unal-edigital2-labs/2020-2-w07_entrega-_final-grupo05/docs/figure/error6.png

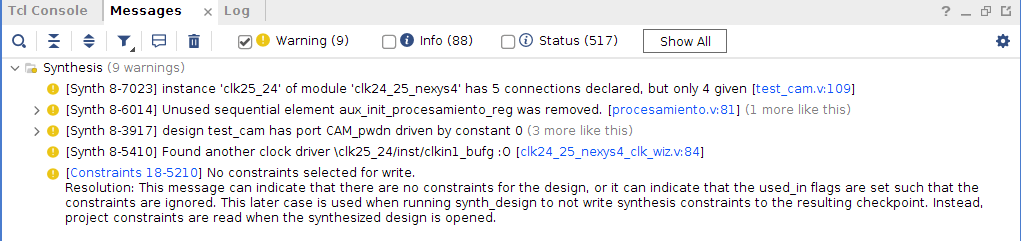
docs/figure/error6.png
