unal-edigital2-labs/2020-2-w07_entrega-_final-grupo05/docs/figure/prueva1ms.png

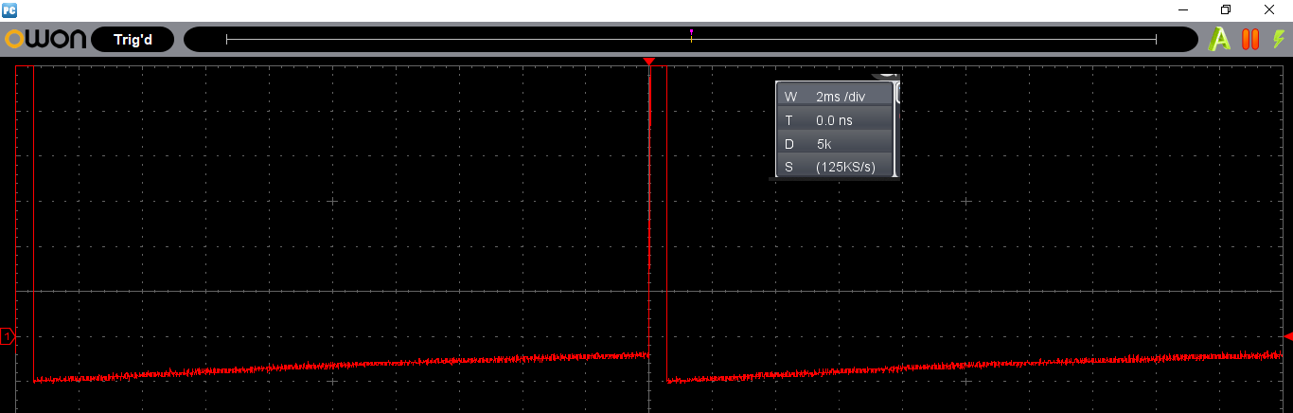
docs/figure/prueva1ms.png
