unal-edigital2-labs/2020-2-w07_entrega-_final-grupo05/docs/figure/pueva15.png

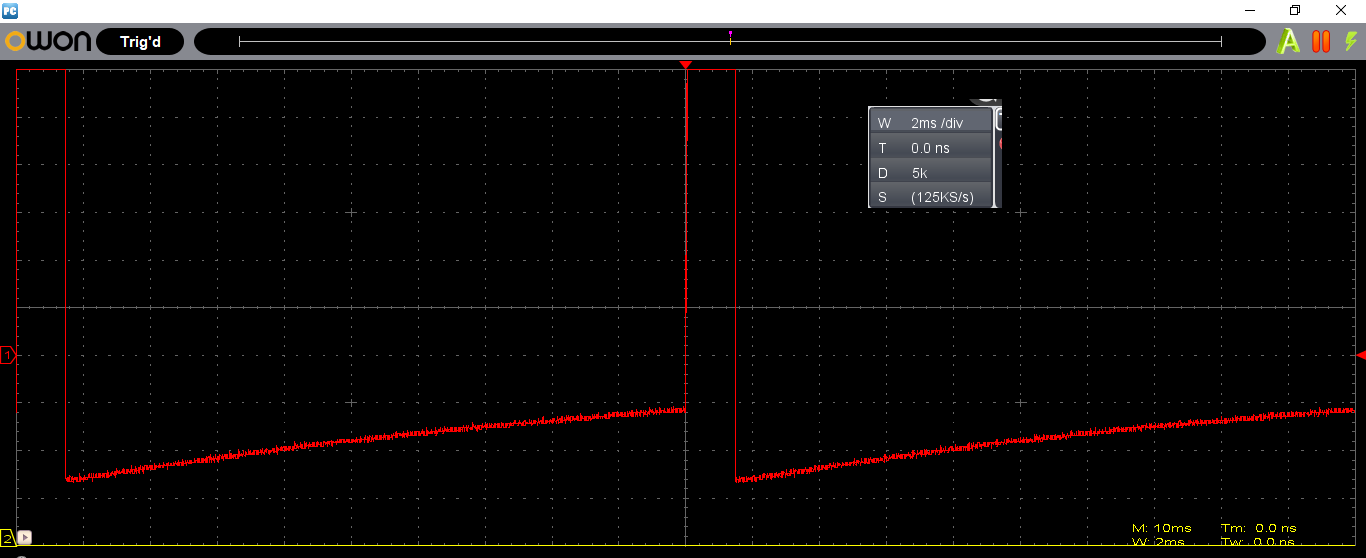
docs/figure/pueva15.png
