unal-edigital2-labs/2020-2-w07_entrega-_final-grupo05/docs/figure/CaputaBuildSoCCPU.jpeg

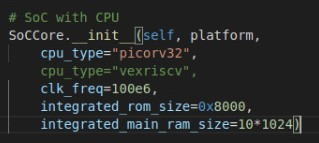
docs/figure/CaputaBuildSoCCPU.jpeg
