unal-edigital2-labs/2020-2-w07_entrega-_final-grupo05/sw/firmware/main.c

#include <stdio.h>
#include <stdlib.h>
#include <string.h>

#include <irq.h>
#include <uart.h>
#include <console.h>
#include <generated/csr.h>

#include "delay.h"
#include "display.h"
#include "camara.h"
#include "radar.h"
#include "motor.h"
#include "infra.h"

static char *readstr(void)
{
	char c[2];
	static char s[64];
	static int ptr = 0;

	if(readchar_nonblock()) {
		c[0] = readchar();
		c[1] = 0;
		switch(c[0]) {
			case 0x7f:
			case 0x08:
				if(ptr > 0) {
					ptr--;
					putsnonl("\x08 \x08");
				}
				break;
			case 0x07:
				break;
			case '\r':
			case '\n':
				s[ptr] = 0x00;
				putsnonl("\n");
				ptr = 0;
				return s;
			default:
				if(ptr >= (sizeof(s) - 1))
					break;
				putsnonl(c);
				s[ptr] = c[0];
				ptr++;
				break;
		}
	}
	return NULL;
}

static char *get_token(char **str)
{
	char *c, *d;

	c = (char *)strchr(*str, ' ');
	if(c == NULL) {
		d = *str;
		*str = *str+strlen(*str);
		return d;
	}
	*c = 0;
	d = *str;
	*str = c+1;
	return d;
}

static void prompt(void)
{
	printf("RUNTIME>");
}

static void help(void)
{
	puts("Available commands:");
	puts("help                            - this command");
	puts("reboot                          - reboot CPU");
	puts("led                             - led test");
	puts("switch                          - switch test");
	puts("display                         - display test");
	puts("rgbled                          - rgb led test");
	puts("vga                             - vga test");
	puts("camara                             - camara test");
	puts("radar                             - radar test"); 
	puts("motor                             - motor test"); 
	puts("infra                            - motor test"); 
}

static void reboot(void)
{
	ctrl_reset_write(1);
}

static void display_test(void)
{
/*	int i;
	signed char defill = 0;	//1->left, -1->right, 0->.
	
	char txtToDisplay[40] = {0, DISPLAY_0, DISPLAY_1,DISPLAY_2,DISPLAY_3,DISPLAY_4,DISPLAY_5,DISPLAY_6,DISPLAY_7,DISPLAY_8,DISPLAY_9,DISPLAY_A,DISPLAY_B,DISPLAY_C,DISPLAY_D,DISPLAY_E,DISPLAY_F,DISPLAY_G,DISPLAY_H,DISPLAY_I,DISPLAY_J,DISPLAY_K,DISPLAY_L,DISPLAY_M,DISPLAY_N,DISPLAY_O,DISPLAY_P,DISPLAY_Q,DISPLAY_R,DISPLAY_S,DISPLAY_T,DISPLAY_U,DISPLAY_V,DISPLAY_W,DISPLAY_X,DISPLAY_Y,DISPLAY_Z,DISPLAY_DP,DISPLAY_TR,DISPLAY_UR};
	
	printf("Test del los display de 7 segmentos... se interrumpe con el botton 1\n");

	while(!(buttons_in_read()&1)) {
		display(txtToDisplay);
		if(buttons_in_read()&(1<<1)) defill = ((defill<=-1) ? -1 : defill-1);
		if(buttons_in_read()&(1<<2)) defill = ((defill>=1) ? 1 : defill+1);
		if (defill > 0) {
			char tmp = txtToDisplay[0];
			for(i=0; i<sizeof(txtToDisplay)/sizeof(txtToDisplay[i]); i++) {
				txtToDisplay[i] = ((i==sizeof(txtToDisplay)/sizeof(txtToDisplay[i])-1) ? tmp : txtToDisplay[i+1]);
			}
		}
		else if(defill < 0) {
			char tmp = txtToDisplay[sizeof(txtToDisplay)/sizeof(txtToDisplay[0])-1];
			for(i=sizeof(txtToDisplay)/sizeof(txtToDisplay[i])-1; i>=0; i--) {
				txtToDisplay[i] = ((i==0) ? tmp : txtToDisplay[i-1]);
			}
		}
		delay_ms(500);
	}
*/
}

static void led_test(void)
{
	unsigned int i;
	printf("Test del los leds... se interrumpe con el botton 1\n");
	while(!(buttons_in_read()&1)) {

	for(i=1; i<65536; i=i*2) {
		leds_out_write(i);
		delay_ms(50);
	}
	for(i=32768;i>1; i=i/2) {
		leds_out_write(i);
		delay_ms(50);
	}
	}
	
}


static void switch_test(void)
{
	unsigned short temp2 =0;
	printf("Test del los interruptores... se interrumpe con el botton 1\n");
	while(!(buttons_in_read()&1)) {
		unsigned short temp = switchs_in_read();
		if (temp2 != temp){
			printf("switch bus : %i\n", temp);
			leds_out_write(temp);
			temp2 = temp;
		}
	}
}
/*
static void rgbled_test(void)
{
	unsigned int T = 128;
	
	ledRGB_1_r_period_write(T);
	ledRGB_1_g_period_write(T);
	ledRGB_1_b_period_write(T);

	ledRGB_1_r_enable_write(1);
	ledRGB_1_g_enable_write(1);
	ledRGB_1_b_enable_write(1);

	
	ledRGB_2_r_period_write(T);
	ledRGB_2_g_period_write(T);
	ledRGB_2_b_period_write(T);
	
	
	ledRGB_2_r_enable_write(1);
	ledRGB_2_g_enable_write(1);
	ledRGB_2_b_enable_write(1);

	for (unsigned int j=0; j<100; j++){
		ledRGB_1_g_width_write(j);
		for (unsigned int i=0; i<100; i++){
			ledRGB_1_r_width_write(100-i);
			ledRGB_1_b_width_write(i);	
			delay_ms(20);
		}	
	}
	


} */


/*
static void vga_test(void)

{
	int x,y;
	
	for(y=0; y<480; y++) {
		for(x=0; x<640; x++) {
			vga_cntrl_mem_we_write(0);
			vga_cntrl_mem_adr_write(y*640+x);
			if(x<640/3)	
				vga_cntrl_mem_data_w_write(((int)(x/10)%2^(int)(y/10)%2)*15);
			else if(x<2*640/3) 
				vga_cntrl_mem_data_w_write((((int)(x/10)%2^(int)(y/10)%2)*15)<<4);
			else 
				vga_cntrl_mem_data_w_write((((int)(x/10)%2^(int)(y/10)%2)*15)<<8);
			vga_cntrl_mem_we_write(1);
		}
	}
	
}
*/
static void camara_test(void)
{
	unsigned short figura=0;
	unsigned short color=0;
	unsigned short done=0;	
	
		
	printf("Hola mundo");
		
	while(!(buttons_in_read()&1)) {

        camara_cntrl_init_procesamiento_write(1);
        delay_ms(2);
        camara_cntrl_init_procesamiento_write(0);
		delay_ms(2);

		done=camara_cntrl_done_read();
		figura=camara_cntrl_figure_read();
		color=camara_cntrl_color_read();
		
		
		
		printf("Done : %i\n", done); 

		if(figura==1) 
			printf("Triangulo\n");
		else if(figura==2) 
			printf("Circulo\n");
		else if(figura==3) 
			printf("Cuadrado\n");
		else if(figura==0) 
			printf("Figura no definida\n");

		if(color==1) 
			printf("Rojo\n");
		else if(color==2) 
			printf("Verde\n");
		else if(color==3) 
			printf("Azul\n");
		else if(color==0) 
			printf("Color no definido\n");
			
		delay_ms(500);
	} 
}

static void radar_test(void)
{
		
	printf("Hola mundo");
		
	while(!(buttons_in_read()&1)) {

    radar_cntrl_boton_cambiar_grados_write(1);
	delay_ms(500);

	radar_cntrl_boton_cambiar_grados_write(2);
	delay_ms(500);
	
	radar_cntrl_boton_cambiar_grados_write(3);
	delay_ms(500);

	radar_cntrl_ultra_write(1);
	delay_ms(5000);	
	radar_cntrl_ultra_write(0);

	}	 
	
}

static void motor_test(void)
{
		
	printf("Hola mundo");
		
	while(!(buttons_in_read()&1)) {

    motor_cntrl_direccion_write(1);
	motor_cntrl_direccion2_write(1);
	delay_ms(5000);	
	motor_cntrl_direccion_write(1);
	motor_cntrl_direccion2_write(0);
    delay_ms(5000);
	motor_cntrl_direccion_write(0);
	motor_cntrl_direccion2_write(1);
	delay_ms(5000);
	motor_cntrl_direccion_write(2);
	motor_cntrl_direccion2_write(2);


    

	}	 
	
}



static void infra_test(void)
{

	unsigned short salida=0;
    unsigned short salida1=0;
    unsigned short salida2=0; 
		
	printf("Hola mundo");
		
	while(!(buttons_in_read()&1)) {
    salida=infra_cntrl_salida_read(); 
    salida1=infra_cntrl_salida1_read();
	salida2=infra_cntrl_salida2_read();

printf("Salida : %i\n", salida); 
printf("Salida1 : %i\n", salida1); 
printf("Salida2 : %i\n", salida2); 
delay_ms(1000);


   


    

	}	 
	
}















static void console_service(void)
{
	char *str;
	char *token;

	str = readstr();
	if(str == NULL) return;
	token = get_token(&str);
	if(strcmp(token, "help") == 0)
		help();
	else if(strcmp(token, "reboot") == 0)
		reboot();
	else if(strcmp(token, "led") == 0)
		led_test();
	else if(strcmp(token, "switch") == 0)
		switch_test();
	else if(strcmp(token, "display") == 0)
		display_test();
//	else if(strcmp(token, "rgbled") == 0)
//		rgbled_test();
//	else if(strcmp(token, "vga") == 0)
//		vga_test();
	else if(strcmp(token, "camara") == 0)
		camara_test();
	else if(strcmp(token, "radar") == 0)
		radar_test();
    else if(strcmp(token, "motor") == 0)
		motor_test();
	else if(strcmp(token, "infra") == 0)
		infra_test();	
	prompt();

}

int main(void)
{
	irq_setmask(0);
	irq_setie(1);
	uart_init();
	camara_init();

	puts("\nSoC - RiscV project UNAL 2020-2-- CPU testing software  interrupt "__DATE__" "__TIME__"\n");
	help();
	prompt();

	while(1) {
		console_service();
	}

	return 0;
}
