unal-edigital2-labs/2020-2-w07_entrega-_final-grupo05/sw/module/verilog/bluetooth/UART_rs232_tx.v

`timescale 1ns / 1ps
//////////////////////////////////////////////////////////////////////////////////
// Company: 
// Engineer: 
// 
// Create Date: 15.12.2020 22:21:46
// Design Name: 
// Module Name: UART_rs232_tx
// Project Name: 
// Target Devices: 
// Tool Versions: 
// Description: 
// 
// Dependencies: 
// 
// Revision:
// Revision 0.01 - File Created
// Additional Comments:
// 
//////////////////////////////////////////////////////////////////////////////////


module UART_rs232_tx(

    );
endmodule
