unal-edigital2-labs/2020-2-w07_entrega-_final-grupo05/(commit log)

2020-12-17 Add files via upload
    no sé que decir
2020-12-17 Archivos faltantes
    [Soc_MemoryMap.csv]
2020-12-18 Arreglos finales
    [Soc_MemoryMap.csv]
2020-12-18 No lo usamos para que lo queremos
